deuskane/asylum-soc-picosoc/(list of files, cad)

Other CAD files:
esw/user_identity.psm
