deuskane/asylum-soc-picosoc/esw/user_modbus_rtu.c

//-----------------------------------------------------------------------------
// Title      : Macro to define Address Map for user soc
// Project    : Asylum
//-----------------------------------------------------------------------------
// File       : user_modbus_rtu.c
// Author     : mrosiere
//-----------------------------------------------------------------------------
// Description:
//-----------------------------------------------------------------------------
// Copyright (c) 2025
//-----------------------------------------------------------------------------
// Revisions  :
// Date        Version  Author   Description
// 2025-10-18  1.0      mrosiere Created
//-----------------------------------------------------------------------------

//#include <intr.h>
#include "addrmap_user.h"
#include "modbus_rtu.h"

//--------------------------------------
// Constant
//--------------------------------------
#define UART_RX_LOOPBACK 0
//#define DISABLE_ERROR
//#define DISABLE_WAIT
//#define UART_ECHO
#define CRC_HW

//--------------------------------------
// crc16_next
// Compute one loop of CRC16
//--------------------------------------
uint16_t crc16_next(uint16_t crc,
                    uint8_t  data)
{
#ifndef CRC_HW
  crc = crc ^ data;

  if ((crc & 0x0001) != 0) {crc >>= 1; crc ^= 0xA001;} else { crc >>= 1; }
  if ((crc & 0x0001) != 0) {crc >>= 1; crc ^= 0xA001;} else { crc >>= 1; }
  if ((crc & 0x0001) != 0) {crc >>= 1; crc ^= 0xA001;} else { crc >>= 1; }
  if ((crc & 0x0001) != 0) {crc >>= 1; crc ^= 0xA001;} else { crc >>= 1; }
  if ((crc & 0x0001) != 0) {crc >>= 1; crc ^= 0xA001;} else { crc >>= 1; }
  if ((crc & 0x0001) != 0) {crc >>= 1; crc ^= 0xA001;} else { crc >>= 1; }
  if ((crc & 0x0001) != 0) {crc >>= 1; crc ^= 0xA001;} else { crc >>= 1; }
  if ((crc & 0x0001) != 0) {crc >>= 1; crc ^= 0xA001;} else { crc >>= 1; }
#else
  uint8_t byte0;
  uint8_t byte1;
  
  crc_wr(CRC,DATA0,data);

  byte1 = crc_rd(CRC,CRC1);
  byte0 = crc_rd(CRC,CRC0);
  crc   = ((byte1<<8)|
           (byte0));
#endif
  return crc;
}

//--------------------------------------
// crc16_init
//--------------------------------------
uint16_t crc16_init()
{
  uint16_t crc;

  crc = 0xFFFF;

#ifdef CRC_HW
  crc_wr(CRC,CRC0,0xFF);
  crc_wr(CRC,CRC1,0xFF);
#endif
  
  return crc;
}

//--------------------------------------
// modbus_response
// send byte to uart and accumulate into crc
//--------------------------------------
uint16_t modbus_response (uint16_t crc,
                          uint8_t  byte
                          )
{
  putchar(byte);
  return crc16_next(crc,byte);
}

//--------------------------------------
// modbus_response_crc
// send the crc to uart (LSB first)
//--------------------------------------
void modbus_response_crc (uint16_t crc)
{
  uint8_t byte;

  byte = crc & 0xFF;
  putchar(byte); // CRC : send LSB first

  byte = (crc >> 8)&0xFF;
  putchar(byte);
}

//--------------------------------------
// _getchar
// fonction to wrap macro getchar
//--------------------------------------
uint8_t _getchar()
{
  volatile uint8_t byte = getchar();

#ifdef UART_ECHO
  putchar(byte);
#endif
  
  return byte;
}

//--------------------------------------
// modbus_wait
// Active loop to Wait 3.5T
// If uart have msg : pop and restart compteur
//--------------------------------------

void modbus_wait ()
{
  uint8_t status = 0;

  // Clear IT From UART
  gic_clr(UART,UART_IT_RX_EMPTY_B_MSK);

  // Start Timer
  timer_unclear(TIMER);
  timer_enable (TIMER);

  while (status == 0x00)
    {
      // Get Status from UART
      status  = gic_get(UART);
      status &= UART_IT_RX_EMPTY_B_MSK;

      // Is RX Not Empty ?
      if (status != 0x00)
        {
          // Pop (and ignore)
          _getchar();
          // Clear IT
          gic_clr(UART,UART_IT_RX_EMPTY_B_MSK);
          // Restart the timer
          timer_clear  (TIMER);
          timer_unclear(TIMER);
        }

      // Get Status from UART
      status  = gic_get(TIMER);
      status &= TIMER_IT_DONE_MSK;
    }

  // Disable Timer
  timer_disable(TIMER);
  timer_clear  (TIMER);

  // Clear IT from Timer
  gic_clr(TIMER,TIMER_IT_DONE_MSK);
}

//--------------------------------------
// modbus_id_req
//
// Check if and return 1 if value for request
//--------------------------------------
uint8_t modbus_id_req(uint8_t id)
{
  uint8_t ret = 0;
  
  if (id == MODBUS_ADDRESS)
    ret=1;
  if (id == 0)
    ret=1;
  return ret;
}

//--------------------------------------
// modbus_id_rsp
//
// Check if and return 1 if value for respons
//--------------------------------------
uint8_t modbus_id_rsp(uint8_t id)
{
  uint8_t ret = 0;
  if (id == MODBUS_ADDRESS)
    ret=1;
  return ret;
}

//--------------------------------------
// modbus_slave_read_holding_registers
//--------------------------------------
uint8_t modbus_slave_read_holding_registers(uint8_t id)
{
  uint8_t  slave_id      = id;
  uint8_t  function_code = MODBUS_FC_READ_HOLDING_REGISTERS;
  uint16_t crc           ;
  uint8_t  errcode       = 0;

  // Read Holding Registers
  // Request must be 8 bytes
  // Respons must be 5+2*N bytes
      
  uint8_t  read_addr_msb;
  uint8_t  read_addr_lsb;
  uint8_t  read_addr    ;
  uint8_t  read_len_msb ;
  uint8_t  read_len_lsb ;
  uint8_t  read_len     ;
  uint8_t  crc_rx_lsb   ;
  uint8_t  crc_rx_msb   ;
  uint16_t crc_rx       ;
  uint8_t  i            ;

  do
    {
#ifndef DISABLE_ERROR
      if (modbus_id_rsp(slave_id)==0)
        break;
#endif
        
      read_addr_msb  = _getchar();
      read_addr_lsb  = _getchar();
      read_len_msb   = _getchar();
      read_len_lsb   = _getchar();
      crc_rx_lsb     = _getchar();
      crc_rx_msb     = _getchar();
      crc_rx         = (crc_rx_msb<<8)|crc_rx_lsb;

      // crc after address = 1 and read
      crc = crc16_init();
      crc = crc16_next(crc,slave_id      );
      crc = crc16_next(crc,function_code );
      crc = crc16_next(crc,read_addr_msb);
      crc = crc16_next(crc,read_addr_lsb);
      crc = crc16_next(crc,read_len_msb);
      crc = crc16_next(crc,read_len_lsb);

#ifndef DISABLE_ERROR
      // If CRC is different, just ignore
      if (crc_rx != crc)
        break;

      // Supported Only 8b Address
      if (read_addr_msb != 0x00)
        {
          errcode = MODBUS_ERR_INVALID_ADDR;
          break;
        }

      // Supported Only 8b  
      if (read_len_msb != 0x00)
        {
          errcode = MODBUS_ERR_INVALID_DATA;
          break;
        }
#endif
        
      read_addr      = read_addr_lsb; // ignore MSB
      read_len       = read_len_lsb ; // ignore MSB
        
      // Response :
      // Byte 0 : Slave ID
      // Byte 1 : Function Code
      // Byte 2 : Number of read bytes
      crc = crc16_init();
      crc = modbus_response(crc,slave_id     );
      crc = modbus_response(crc,function_code);
      crc = modbus_response(crc,read_len << 1); // read_len is in read word so 16b

      // Byte 3 : read data MSB
      // Byte 4 : read data LSB
      for (i = 0; i < read_len; i++)
        {
          //uint16_t read_data = holding_registers[read_addr + i];
          //crc = modbus_response(crc,(read_data >> 8  ));
          //crc = modbus_response(crc,(read_data & 0xFF));

          uint8_t read_data = PORT_RD(0,read_addr);
          crc = modbus_response(crc,0x00);
          crc = modbus_response(crc,read_data);
          read_addr ++;
        }

      modbus_response_crc(crc);
    }
  while (0);
  
  return errcode;
}
  
//--------------------------------------
// modbus_slave_write_single_register
//--------------------------------------
uint8_t modbus_slave_write_single_register(uint8_t id)
{
  uint8_t  slave_id      = id;
  uint8_t  function_code = MODBUS_FC_WRITE_SINGLE_REGISTER;
  uint16_t crc           ;
  uint8_t  errcode       = 0;

  // Write Single Register
  uint8_t  write_addr_msb ;
  uint8_t  write_addr_lsb ;
  uint8_t  write_data_msb ;
  uint8_t  write_data_lsb ;
  uint8_t  crc_rx_lsb     ;
  uint8_t  crc_rx_msb     ;
  uint16_t crc_rx         ;

  do
    {
  
#ifndef DISABLE_ERROR
      if (modbus_id_req(slave_id)==0)
        break;
#endif
        
      // Modbus uses 16b address and 16b data
      // here -> ignore MSB
            
      write_addr_msb = _getchar();
      write_addr_lsb = _getchar();
      write_data_msb = _getchar();
      write_data_lsb = _getchar();
      crc_rx_lsb     = _getchar();
      crc_rx_msb     = _getchar();
      crc_rx         = (crc_rx_msb<<8)|crc_rx_lsb;
            
      // crc after address = 1 and write
      crc = crc16_init();
      crc = crc16_next(crc,slave_id      );
      crc = crc16_next(crc,function_code );
      crc = crc16_next(crc,write_addr_msb);
      crc = crc16_next(crc,write_addr_lsb);
      crc = crc16_next(crc,write_data_msb);
      crc = crc16_next(crc,write_data_lsb);

#ifndef DISABLE_ERROR
      // If CRC is different, just ignore
      if (crc_rx != crc)
        break;

      // Supported Only 8b Address
      if (write_addr_msb != 0x00)
        {
          errcode = MODBUS_ERR_INVALID_ADDR;
          break;
        }

      // Supported Only 8b  
      if (write_data_msb != 0x00)
        {
          errcode = MODBUS_ERR_INVALID_DATA;
          break;
        }
#endif
        
      PORT_WR(0,write_addr_lsb,write_data_lsb);

#ifndef DISABLE_ERROR
      if (modbus_id_rsp(slave_id)==0)
        break;
#endif
        
      // Respons is the same like request
      crc = crc16_init();
      crc = modbus_response(crc,slave_id      ); 
      crc = modbus_response(crc,function_code ); 
      crc = modbus_response(crc,0x00          ); 
      crc = modbus_response(crc,write_addr_lsb); 
      crc = modbus_response(crc,0x00          ); 
      crc = modbus_response(crc,write_data_lsb); 
      modbus_response_crc(crc);
    }
  while (0);
  
  return errcode;
}

//--------------------------------------
// modbus_slave
// send byte to uart and accumulate into crc
//--------------------------------------
void modbus_slave ()
{
  uint8_t  slave_id      ;
  uint8_t  function_code ;
  uint16_t crc           ;
  uint8_t  errcode       ;

  // not yet error
  errcode       = 0;

  // Get Slave ID and check
  slave_id      = _getchar();
  
  // Get Function code
  function_code = _getchar();
  
  if      (function_code == MODBUS_FC_READ_HOLDING_REGISTERS)
    {
      errcode = modbus_slave_read_holding_registers(slave_id);
    }
  else if (function_code == MODBUS_FC_WRITE_SINGLE_REGISTER)
    {
      errcode = modbus_slave_write_single_register(slave_id);
    }
  else 
      // Unsupported Function
    {
      errcode = MODBUS_ERR_INVALID_FUNC;
    }
  
  // Have Error ?
  if (errcode != 0)
    {
      crc = crc16_init();
      crc = modbus_response(crc,slave_id      ); 
      crc = modbus_response(crc,(function_code|0x80)); 
      crc = modbus_response(crc,errcode       ); 
      modbus_response_crc(crc);
    }
}

//--------------------------------------
// Interrupt Sub Routine
//--------------------------------------
ISR_FCT
{
}

//--------------------------------------
// Application Setup
//--------------------------------------
void setup()
{
  uint32_t timer_cnt;
  
  // GPIO Setup
  // * SWITCH is Input
  // * LED    are Output and init to 0
  gpio_setup(SWITCH,INPUT);
  gpio_setup(LED0  ,OUTPUT);
  gpio_setup(LED1  ,OUTPUT);
  gpio_wr(LED0,0);
  gpio_wr(LED1,0);

  // UART
  // * Setup the clock frequency and the target Baud Rate
  // * Configurae the Uart RX Loopback
  // * Enable the Interruption UART RX Empty interuption
  uart_setup(UART,CLOCK_FREQ,BAUD_RATE,UART_RX_LOOPBACK);
  gic_it_enable(UART,UART_IT_RX_EMPTY_B_MSK);

  // TIMER
  // * Setup time for 3.5 STOP char
  //   Char = 1 START + 8 DATA + 1 STOP -> 10b
  //   Tchar = 10*CLOCK_FREQ/BAUD_RATE
  timer_cnt = (3.5 * 10 * CLOCK_FREQ)/(BAUD_RATE);
  timer_wr(TIMER,timer_cnt);
  gic_it_enable(TIMER,TIMER_IT_DONE_MSK);
  
  // Setup the interruption handler address in the CPU
  interrupt_setup(isr);

  // Enable Interrtuption in the CPU
  //interrupt_enable();
}


//--------------------------------------
// Main
//--------------------------------------
// Arduino Style, Don't modify
void main()
{

  setup();

  //------------------------------------
  // Application Run Loop
  //------------------------------------

  while (1)
    {
#ifndef DISABLE_WAIT
      modbus_wait   ();
#endif
      modbus_slave  ();
    }
}
