deuskane/asylum-soc-picosoc/hdl/PicoSoC_supervisor.vhd

-------------------------------------------------------------------------------
-- Title      : PicoSoC_supervisor
-- Project    : 
-------------------------------------------------------------------------------
-- File       : PicoSoC_supervisor.vhd
-- Author     : Mathieu Rosiere
-- Company    : 
-- Created    : 2017-03-30
-- Last update: 2026-07-20
-- Platform   : 
-- Standard   : VHDL'93/02
-------------------------------------------------------------------------------
-- Description: 
-------------------------------------------------------------------------------
-- Copyright (c) 2017 
-------------------------------------------------------------------------------
-- Revisions  :
-- Date        Version  Author   Description
-- 2025-01-01  1.0      mrosiere Created
-- 2025-04-02  1.1      mrosiere Add ICN
-- 2025-07-05  1.2      mrosiere Use GIC instead GPIO
-- 2026-05-17  1.3      mrosiere Add RAM
-- 2026-08-01  1.4      mrosiere Use GPIO_irq instead of GPIO
-------------------------------------------------------------------------------

library ieee;
use     ieee.std_logic_1164.all;
use     ieee.numeric_std.all;
library asylum;

-- Type Package
use     asylum.sbi_pkg.all;
use     asylum.math_pkg.all;
-- CSR Package
use     asylum.GPIO_irq_csr_pkg.all;
use     asylum.GIC_csr_pkg.all;
-- Modules Packages
use     asylum.PicoSoC_pkg.all;
use     asylum.gpio_pkg.all;
use     asylum.gic_pkg.all;
use     asylum.icn_pkg.all;
use     asylum.ram_pkg.all;
use     asylum.ROM_supervisor_pkg.all;

entity PicoSoC_supervisor is
  generic
    (NB_LED0               : positive := 8
    ;NB_LED1               : positive := 8

    ;ICN_TARGET_SEL        : string   := "or"
    ;ICN_MASTER_SEL        : string   := "fix"

    ;NB_CPU                : natural  := 1
    ;CPU_MODEL             : string   := "OpenBlaze8" 
    ;RAM_DEPTH             : natural  := 128
    );
  port
    (clk_i                 : in  std_logic
    ;arst_b_i              : in  std_logic
                          
    ;led0_o                : out std_logic_vector(NB_LED0  -1 downto 0)
    ;led1_o                : out std_logic_vector(NB_LED1  -1 downto 0)
                          
    ;diff_i                : in  std_logic_vector(        3-1 downto 0)
                          
    ;debug_o               : out PicoSoC_supervisor_debug_t
     );
end PicoSoC_supervisor;

architecture rtl of PicoSoC_supervisor is
  -- Constant declaration
  constant CST0                       : std_logic_vector (8-1 downto 0) := (others => '0');
  constant CST1                       : std_logic_vector (8-1 downto 0) := (others => '1');

  -- CPU parameters
  constant CPU_IMEM_ADDR_WIDTH        : positive := ROM_supervisor_ADDR_WIDTH;
  constant CPU_IMEM_DATA_WIDTH        : positive := ROM_supervisor_DATA_WIDTH;
  constant CPU_DMEM_ADDR_WIDTH        : positive := SBI_ADDR_WIDTH;
  constant CPU_DMEM_DATA_WIDTH        : positive := SBI_DATA_WIDTH;

  -- ICN Configuration
  constant ICN_NB_MASTER              : positive := NB_CPU;

  constant ICN_TARGET_ADDR_ENCODING   : string   := PICOSOC_SUPERVISOR_ADDR_ENCODING;

  constant ICN_TARGET_LED0            : integer  := 0;
  constant ICN_TARGET_LED1            : integer  := 1;
  constant ICN_TARGET_GIC             : integer  := 2;
  constant ICN_TARGET_RAM             : integer  := 3;

  constant ICN_NB_TARGET              : positive := 4;

  constant ICN_TARGET_ID              : sbi_addrs_t   (ICN_NB_TARGET-1 downto 0) :=
    ( ICN_TARGET_LED0                 => PICOSOC_SUPERVISOR_LED0_BA
     ,ICN_TARGET_LED1                 => PICOSOC_SUPERVISOR_LED1_BA
     ,ICN_TARGET_GIC                  => PICOSOC_SUPERVISOR_GIC_BA 
     ,ICN_TARGET_RAM                  => PICOSOC_SUPERVISOR_RAM_BA
      );
  constant ICN_TARGET_ADDR_WIDTH      : naturals_t    (ICN_NB_TARGET-1 downto 0) :=
    ( ICN_TARGET_LED0                 => GPIO_IRQ_ADDR_WIDTH
     ,ICN_TARGET_LED1                 => GPIO_IRQ_ADDR_WIDTH
     ,ICN_TARGET_GIC                  => GIC_ADDR_WIDTH
     ,ICN_TARGET_RAM                  => log2(RAM_DEPTH)
      );
      
  -- Signals Clock/Reset
  signal clk                          : std_logic;
  signal arst_b                       : std_logic;
  
  -- Signals CPUs
  signal cpu_ics                      : std_logic;
  signal cpu_iaddr                    : std_logic_vector(CPU_IMEM_ADDR_WIDTH-1 downto 0);
  signal cpu_idata                    : std_logic_vector(CPU_IMEM_DATA_WIDTH-1 downto 0);
  
  signal cpu_sbi_ini                  : sbi_ini_t(addr (CPU_DMEM_ADDR_WIDTH-1 downto 0),
                                                  wdata(CPU_DMEM_DATA_WIDTH-1 downto 0));
  signal cpu_sbi_tgt                  : sbi_tgt_t(rdata(CPU_DMEM_DATA_WIDTH-1 downto 0));

  signal cpu_it_val                   : std_logic;
--signal cpu_it_ack                   : std_logic;

  -- Signals ICN
  signal icn_sbi_inim                 : sbi_inis_t(ICN_NB_MASTER-1 downto 0)(addr (CPU_DMEM_ADDR_WIDTH-1 downto 0),
                                                                             wdata(CPU_DMEM_DATA_WIDTH-1 downto 0));
  signal icn_sbi_tgtm                 : sbi_tgts_t(ICN_NB_MASTER-1 downto 0)(rdata(CPU_DMEM_DATA_WIDTH-1 downto 0));

  signal icn_sbi_inis                 : sbi_inis_t(ICN_NB_TARGET-1 downto 0)(addr (CPU_DMEM_ADDR_WIDTH-1 downto 0),
                                                                             wdata(CPU_DMEM_DATA_WIDTH-1 downto 0));
  signal icn_sbi_tgts                 : sbi_tgts_t(ICN_NB_TARGET-1 downto 0)(rdata(CPU_DMEM_DATA_WIDTH-1 downto 0));
  
  signal led0                         : std_logic_vector(NB_LED0-1 downto 0);
  signal led1                         : std_logic_vector(NB_LED1-1 downto 0);
  
  -- Interruption Vector
  constant GIC_ITS_SYNC_ENABLE        : std_logic_vector(diff_i'range) := (others      => '0');
  
begin  -- architecture rtl

  -----------------------------------------------------------------------------
  -- Clock & Reset
  -----------------------------------------------------------------------------
  clk    <= clk_i;
  arst_b <= arst_b_i;
  
  -----------------------------------------------------------------------------
  -- CPU 0
  -----------------------------------------------------------------------------
  ins_cpu : entity asylum.cpu_wrapper
    generic map
    (CPU_MODEL            => CPU_MODEL
    )
    port map
    (clk_i                => clk      
    ,cke_i                => '1'      
    ,arst_b_i             => arst_b   
    ,ics_o                => cpu_ics  
    ,iaddr_o              => cpu_iaddr
    ,idata_i              => cpu_idata
    ,sbi_ini_o            => cpu_sbi_ini  
    ,sbi_tgt_i            => cpu_sbi_tgt  
    ,interrupt_i          => cpu_it_val   
    ,interrupt_ack_o      => open
    );

  icn_sbi_inim(0) <= cpu_sbi_ini;
  cpu_sbi_tgt     <= icn_sbi_tgtm(0);

  -----------------------------------------------------------------------------
  -- CPU ROM
  -----------------------------------------------------------------------------
  ins_ROM_supervisor : entity asylum.ROM_supervisor(rom)
    port map
    (clk_i                => clk      
    ,cke_i                => cpu_ics
    ,address_i            => cpu_iaddr
    ,instruction_o        => cpu_idata  
    );

  -----------------------------------------------------------------------------
  -- Interconnect
  -- From 1 Initiator to N Target
  -----------------------------------------------------------------------------
  ins_sbi_icn : sbi_icn
    generic map
    (NAME                 => "icn_supervisor"
    ,NB_MASTER            => ICN_NB_MASTER
    ,MASTER_SEL           => ICN_MASTER_SEL
    ,NB_TARGET            => ICN_NB_TARGET
    ,TARGET_SEL           => ICN_TARGET_SEL
    ,TARGET_ID            => ICN_TARGET_ID
    ,TARGET_ADDR_WIDTH    => ICN_TARGET_ADDR_WIDTH
    ,TARGET_ADDR_ENCODING => ICN_TARGET_ADDR_ENCODING
     )
    port map
    (clk_i                => clk        
    ,cke_i                => '1'        
    ,arst_b_i             => arst_b     
    ,sbi_inis_i           => icn_sbi_inim
    ,sbi_tgts_o           => icn_sbi_tgtm  
    ,sbi_inis_o           => icn_sbi_inis   
    ,sbi_tgts_i           => icn_sbi_tgts
     );

  -----------------------------------------------------------------------------
  -- GPIO 0 - LED
  -- Used as resetb for soc user
  -----------------------------------------------------------------------------
  ins_sbi_led0 : sbi_GPIO_irq
    generic map
    (NAME                 => "USER_ARST"
    ,NB_IO                => NB_LED0
    ,DATA_OE_INIT         => CST1(8-1 downto 0)
    ,IRQ_POSEDGE          => X"00"
    ,IRQ_NEGEDGE          => X"00"
   )
    port map
    (clk_i                => clk         
    ,cke_i                => '1'         
    ,arstn_i              => arst_b      
    ,sbi_ini_i            => icn_sbi_inis(ICN_TARGET_LED0)
    ,sbi_tgt_o            => icn_sbi_tgts(ICN_TARGET_LED0)
    ,data_i               => CST0(NB_LED0-1 downto 0)
    ,data_o               => led0        
    ,data_oe_o            => open   
    ,it_o                 => open       
    );

  -----------------------------------------------------------------------------
  -- GPIO 1 - LED
  -----------------------------------------------------------------------------
  ins_sbi_led1 : sbi_GPIO_irq
    generic map
    (NAME                 => "LED_DIFF"
    ,NB_IO                => NB_LED1
    ,DATA_OE_INIT         => CST1(8-1 downto 0)
    ,IRQ_POSEDGE          => X"00"
    ,IRQ_NEGEDGE          => X"00"
    )
    port map
    (clk_i                => clk         
    ,cke_i                => '1'         
    ,arstn_i              => arst_b      
    ,sbi_ini_i            => icn_sbi_inis(ICN_TARGET_LED1)
    ,sbi_tgt_o            => icn_sbi_tgts(ICN_TARGET_LED1)
    ,data_i               => CST0(NB_LED1-1 downto 0)
    ,data_o               => led1        
    ,data_oe_o            => open        
    ,it_o                 => open       
    );

  -----------------------------------------------------------------------------
  -- GIC - Interruption Vector
  -----------------------------------------------------------------------------
  ins_sbi_gic : sbi_GIC
    generic map
    (ITS_SYNC_ENABLE      => GIC_ITS_SYNC_ENABLE
     )
    port map
    (clk_i                => clk         
    ,arst_b_i             => arst_b      
    ,sbi_ini_i            => icn_sbi_inis(ICN_TARGET_GIC)
    ,sbi_tgt_o            => icn_sbi_tgts(ICN_TARGET_GIC)
    ,its_i                => diff_i      
    ,itm_o                => cpu_it_val
    );
  
  -----------------------------------------------------------------------------
  -- RAM
  -----------------------------------------------------------------------------
  ins_sbi_ram : sbi_ram
    generic map
    (DEPTH                => RAM_DEPTH
    ,SYNC_READ            => true   
   )
    port map
    (clk_i                => clk         
    ,arst_b_i             => arst_b      
    ,sbi_ini_i            => icn_sbi_inis(ICN_TARGET_RAM)
    ,sbi_tgt_o            => icn_sbi_tgts(ICN_TARGET_RAM)
    );
 
  -----------------------------------------------------------------------------
  -- Output
  -----------------------------------------------------------------------------
  led0_o <= led0;
  led1_o <= led1;

  -----------------------------------------------------------------------------
  -- Debug
  -----------------------------------------------------------------------------
  debug_o.arst_b <= arst_b;
  
end architecture rtl;
    
  
