deuskane/asylum-soc-picosoc/esw/include/cpu.h

//-----------------------------------------------------------------------------
// Title      : Macro for cpu
// Project    : Asylum
//-----------------------------------------------------------------------------
// File       : cpu.h
// Author     : mrosiere
//-----------------------------------------------------------------------------
// Description:
//-----------------------------------------------------------------------------
// Copyright (c) 2025
//-----------------------------------------------------------------------------
// Revisions  :
// Date        Version  Author   Description
// 2026-05-17  1.0      mrosiere Created
//-----------------------------------------------------------------------------

#ifndef _cpu_h_
#define _cpu_h_

#ifdef picoblaze

#include "cpu/picoblaze.h"

#else

#include "cpu/riscv.h"

#endif
#endif
