deuskane/asylum-soc-picosoc/esw/include/addrmap_supervisor.h

//-----------------------------------------------------------------------------
// Title      : Macro to define Address Map for supervisor soc
// Project    : Asylum
//-----------------------------------------------------------------------------
// File       : addrmap_supervisor.h
// Author     : mrosiere
//-----------------------------------------------------------------------------
// Description:
//-----------------------------------------------------------------------------
// Copyright (c) 2025
//-----------------------------------------------------------------------------
// Revisions  :
// Date        Version  Author   Description
// 2025-07-31  1.0      mrosiere Created
//-----------------------------------------------------------------------------

#ifndef _addrmap_supervisor_h_
#define _addrmap_supervisor_h_

//--------------------------------------
// IP
//--------------------------------------

#include "picoblaze.h"
#include "gpio.h"
#include "gic.h"

//--------------------------------------
// Address Map
//--------------------------------------
#define RST                 0x10
#define LED                 0x20
#define GIC                 0x40

#endif
