deuskane/asylum-soc-picosoc/sim/tb_PicoSoC.vhd

-------------------------------------------------------------------------------
-- Title      : tb_PicoSoC
-- Project    : 
-------------------------------------------------------------------------------
-- File       : tb_PicoSoC.vhd
-- Author     : Mathieu Rosiere
-- Company    : 
-- Created    : 2017-03-30
-- Last update: 2026-01-10
-- Platform   : 
-- Standard   : VHDL'93/02
-------------------------------------------------------------------------------
-- Description: 
-------------------------------------------------------------------------------
-- Copyright (c) 2017 
-------------------------------------------------------------------------------
-- Revisions  :
-- Date        Version  Author  Description
-- 2017-03-30  1.0      mrosiere Created
-- 2025-01-11  1.1      mrosiere Add fault test
-------------------------------------------------------------------------------

library ieee;
use     ieee.std_logic_1164.all;
use     ieee.numeric_std.all;
use     std.textio.all;
library asylum;
use     asylum.PicoSoC_pkg.all;
use     asylum.spi_pkg.all;
library work;
  
entity tb_PicoSoC is
  generic
    (FSYS                  : positive := 50_000_000
    ;FSYS_INT              : positive := 50_000_000
    ;USER_NB_CPU           : positive := 1
    ;USER_BAUD_RATE        : integer  := 115200
  --;USER_UART_DEPTH_TX    : natural  := 0
  --;USER_UART_DEPTH_RX    : natural  := 0
  --;USER_SPI_DEPTH_CMD    : natural  := 0
  --;USER_SPI_DEPTH_TX     : natural  := 0
  --;USER_SPI_DEPTH_RX     : natural  := 0
  --;USER_NB_SWITCH        : positive := 8
  --;USER_NB_LED0          : positive := 8
  --;USER_NB_LED1          : positive := 8
  --;RESET_POLARITY        : string   := "low"       -- "high" / "low"
    ;SUPERVISOR            : boolean  := True 
    ;USER_SAFETY           : string   := "lock-step" -- "none" / "lock-step" / "tmr"
    ;USER_FAULT_INJECTION  : boolean  := True  
  --;USER_IT_POLARITY      : string   := "low"       -- "high" / "low"
  --;USER_FAULT_POLARITY   : string   := "low"       -- "high" / "low"
    ;DEBUG_ENABLE          : boolean  := True 
    ;CPU_MODEL             : string   := ""          -- "OpenBlaze8" / "WardRV_fsm"

    -- TB Parameters
    ;TEST_SUITE            : string   := "default"   -- "default"/"none" 
    ;TB_WATCHDOG           : natural  := 10_000
    ;SPI_MODEL             : string   := "none"      -- "none" / "m25p40" / "s25fl512s"

     );
  
end entity tb_PicoSoC;

architecture tb of tb_PicoSoC is
  -- =====[ Parameters ]==========================
  constant TB_PERIOD               : time    := (1e9 / FSYS) * 1 ns;
  constant TB_WATCHDOG_TIME        : time    := TB_WATCHDOG * TB_PERIOD;

  constant USER_NB_SWITCH          : positive :=  8;
  constant USER_NB_LED0            : positive :=  8;
  constant USER_NB_LED1            : positive :=  8;
  constant USER_SPI_NB_IO          : positive :=  8;

  constant RESET_POLARITY          : string   := "low";  -- "high" / "low"
  constant USER_IT_POLARITY        : string   := "high"; -- "high" / "low"
  constant USER_FAULT_POLARITY     : string   := "high"; -- "high" / "low"
  
  -- =====[ Dut Signals ]=========================
  signal  clk_i                    : std_logic := '0';
  signal  arst_b_i                 : std_logic;
  signal  switch_i                 : std_logic_vector(USER_NB_SWITCH-1 downto 0);
  signal  led0_o                   : std_logic_vector(USER_NB_LED0  -1 downto 0);
  signal  led1_o                   : std_logic_vector(USER_NB_LED1  -1 downto 0);
  signal  led_diff_o               : std_logic_vector(             3-1 downto 0);
  signal  it_user_i                : std_logic;
  signal  inject_error_i           : std_logic_vector(             3-1 downto 0);

  signal  spi_sclk_io              : std_logic;
  signal  spi_cs_b_io              : std_logic;
  signal  spi_io_io                : std_logic_vector(USER_SPI_NB_IO-1 downto 0);

  signal  RSTNeg                   : std_logic;
  
  alias   led_switch               : std_logic_vector(USER_NB_SWITCH-1 downto 0) is led0_o(USER_NB_SWITCH-1 downto  0);
  alias   led_it                   : std_logic_vector(USER_NB_LED1  -1 downto 0) is led1_o;
  alias   led_diff                 : std_logic_vector(             3-1 downto 0) is led_diff_o;

  -- =====[ Test Signals ]========================
  signal  test_begin               : std_logic := '0';
  signal  test_done                : std_logic := '0';
  
  -- =====[ Functions ]===========================
  
  -----------------------------------------------------------------------------
  -- xrun
  -----------------------------------------------------------------------------
  procedure xrun
    (constant n     : in positive;           -- nb cycle
     constant pol   : in string;
     signal   clk   : in std_logic
     ) is
    
  begin
    for i in 0 to n-1
    loop
      if (pol="pos")
      then
        wait until rising_edge(clk);
      else
        wait until falling_edge(clk);
      end if;
      
    end loop;  -- i
  end xrun;

  -----------------------------------------------------------------------------
  -- run
  -----------------------------------------------------------------------------
  procedure run
    (constant n     : in positive;          -- nb cycle
     constant pol   : in string := "pos"
     ) is
    
  begin
    xrun(n,"pos",clk_i);
  end run;

begin  -- architecture tb

  -----------------------------------------------------------------------------
  -- Design Under Test
  -----------------------------------------------------------------------------
  dut : PicoSoC_top
    generic map
    (FSYS                  => FSYS            
    ,FSYS_INT              => FSYS_INT        
    ,USER_NB_CPU           => USER_NB_CPU
    ,USER_BAUD_RATE        => USER_BAUD_RATE
    ,USER_NB_SWITCH        => USER_NB_SWITCH       
    ,USER_NB_LED0          => USER_NB_LED0        
    ,USER_NB_LED1          => USER_NB_LED1   
    ,USER_SPI_NB_IO        => USER_SPI_NB_IO     
    ,RESET_POLARITY        => RESET_POLARITY  
    ,SUPERVISOR            => SUPERVISOR      
    ,USER_SAFETY           => USER_SAFETY          
    ,USER_FAULT_INJECTION  => USER_FAULT_INJECTION 
    ,USER_IT_POLARITY      => USER_IT_POLARITY
    ,USER_FAULT_POLARITY   => USER_FAULT_POLARITY  
    ,CPU_MODEL             => CPU_MODEL
     )  
    port map
    (clk_i            => clk_i           
    ,arst_i           => arst_b_i        
    ,switch_i         => switch_i        
    ,led0_o           => led0_o
    ,led1_o           => led1_o
    ,led_diff_o       => led_diff_o
    ,it_user_i        => it_user_i     
    ,inject_error_i   => inject_error_i
    ,uart_tx_o        => open
    ,uart_rx_i        => '1'
    ,uart_cts_b_i     => '0'
    ,uart_rts_b_o     => open
    ,spi_sclk_io      => spi_sclk_io
    ,spi_cs_b_io      => spi_cs_b_io
    ,spi_io_io        => spi_io_io
    ,debug_mux_i      => "000"
    ,debug_o          => open 
    ,debug_uart_tx_o  => open
    );

  -----------------------------------------------------------------------------
  -- Clock Tree
  -----------------------------------------------------------------------------
  clk_i <= not test_done and not clk_i after TB_PERIOD/2;

  -----------------------------------------------------------------------------
  -- Memory Model
  -----------------------------------------------------------------------------
  RSTNeg  <= '1';

  gen_m25p40:
  if SPI_MODEL = "m25p40" 
  generate
    mem : entity work.m25p40(vhdl_behavioral)
      generic map 
      (mem_file_name  => "memory.mem"
      ,UserPreload    => true
      ,DebugInfo      => true
      ,TimingChecksOn => true
      ,MsgOn          => true
      ,XOn            => true
      ,LongTimming    => False
      )
      port map
      (D             => spi_io_io(SPI_IO_MOSI)
      ,Q             => spi_io_io(SPI_IO_MISO)
      ,C             => spi_sclk_io
      ,SNeg          => spi_cs_b_io
      ,WNeg          => spi_io_io(SPI_IO_WP_B)
      ,HOLDNeg       => spi_io_io(SPI_IO_HOLD_B)
      );
  end generate;

  gen_s25fl512s:
  if SPI_MODEL = "s25fl512s" 
  generate
    mem : entity work.s25fl512s(vhdl_behavioral_static_memory_allocation)
      generic map
      (mem_file_name  => "memory.mem"
      ,otp_file_name  => "none"
      ,UserPreload    => true
      ,TimingChecksOn => true
      ,MsgOn          => true
      ,XOn            => true
      ,TimingModel    => "S25FL512SAGMFI010_F_30pF"
      ,LongTimming    => false
      )
      PORT MAP
      (SI            => spi_io_io(SPI_IO_MOSI)
      ,SO            => spi_io_io(SPI_IO_MISO)
      ,SCK           => spi_sclk_io
      ,CSNeg         => spi_cs_b_io
      ,WPNeg         => spi_io_io(SPI_IO_WP_B)
      ,HOLDNeg       => spi_io_io(SPI_IO_HOLD_B)
      ,RSTNeg        => RSTNeg
      );
  end generate;
  
  -----------------------------------------------------------------------------
  -- Watchdog
  -----------------------------------------------------------------------------
  p_watchdog: process is
  begin
    while (test_begin = '0')
    loop
      run(1);
    end loop;

    wait for TB_WATCHDOG_TIME;

    run(1);
    
    assert (test_done = '1') report "[TESTBENCH] Test KO : Maximum cycle is reached" severity failure;

    -- end of process
    wait;
  end process;
  
  -----------------------------------------------------------------------------
  -- Test suite
  -----------------------------------------------------------------------------
  process is
  begin  -- process

      run(10);

      report "[TESTBENCH] Init signals";
      it_user_i      <= '0';             -- active low
      inject_error_i <= (others => '0'); -- active low

      report "[TESTBENCH] Reset Sequence"; 
      arst_b_i       <= '0';

      if SPI_MODEL /= "none"
      then
        wait for 10 ms;
      end if;
      
      run(1);

      test_begin     <= '1';
      arst_b_i       <= '1';

      -------------------------------------------------------------------------
      if TEST_SUITE = "default"
      -------------------------------------------------------------------------
      then
      
        report "[TESTBENCH] Change Switch" ;
        switch_i       <= (others => '0');
        for i in USER_NB_SWITCH-1 downto 0 loop
          report "[TESTBENCH]   Switch " & integer'image(i);
          switch_i(i)    <= '1';
          wait until (led_switch = switch_i) ;
          
        end loop;  -- i
  
        report "[TESTBENCH] User Interruption" ;
        run(1,"neg");
        it_user_i        <= '1';
        run(1,"neg");
        it_user_i        <= '0';
        run(1000);
  
        run(1,"neg");
        it_user_i        <= '1';
        run(100);
        run(1,"neg");
        it_user_i        <= '0';
        run(1000);
        
        if (USER_FAULT_INJECTION and SUPERVISOR and USER_SAFETY="lock-step")
        then
          report "[TESTBENCH] Inject error (lock-step)" ;
          assert led_diff = "000" report "Bad value of led_diff" severity failure;
          
          report "[TESTBENCH] Inject error in CPU0" ;
          inject_error_i(0) <= '1';
          run(100);
          inject_error_i(0) <= '0';
  
          while (not (led_switch /= switch_i))
          loop
            run(1);
          end loop;
          while (not (led_switch  = switch_i))
          loop
            run(1);
          end loop;
  
          report "[TESTBENCH] Inject error in CPU1" ;
          inject_error_i(1) <= '1';
          run(100);
          inject_error_i(1) <= '0';
  
          while (not (led_switch /= switch_i))
          loop
            run(1);
          end loop;
          while (not (led_switch  = switch_i))
          loop
            run(1);
          end loop;
  
          report "[TESTBENCH] Inject error in CPU0 in continue" ;
          inject_error_i(1) <= '1';
          run(100);
          inject_error_i(1) <= '0';
  
        end if;
  
        if (USER_FAULT_INJECTION and SUPERVISOR and USER_SAFETY="tmr")
        then
          report "[TESTBENCH] Inject error (TMR)" ;
          assert led_diff = "000" report "Bad value of led_diff" severity failure;
          
          report "[TESTBENCH] Inject error in CPU0" ;
          inject_error_i(0) <= '1';
          run(100);
          inject_error_i(0) <= '0';
  
          run(100);
          assert led_switch  = switch_i report "Bad value of led_switch" severity failure;
          assert led_diff    = "000"    report "Bad value of led_diff"   severity failure;
  
          report "[TESTBENCH] Inject error in CPU1" ;
          inject_error_i(1) <= '1';
          run(100);
          inject_error_i(1) <= '0';
  
          while (not (led_switch /= switch_i))
          loop
            run(1);
          end loop;
          while (not (led_switch  = switch_i))
          loop
            run(1);
          end loop;
  
          assert led_switch  = switch_i report "Bad value of led_switch" severity failure;
          assert led_diff    = "001"    report "Bad value of led_diff"   severity failure;
  
          report "[TESTBENCH] Inject error in CPU2" ;
          inject_error_i(2) <= '1';
          run(100);
          inject_error_i(2) <= '0';
  
          run(100);
          assert led_switch  = switch_i report "Bad value of led_switch" severity failure;
          assert led_diff    = "001"    report "Bad value of led_diff"   severity failure;
  
          report "[TESTBENCH] Inject error in CPU2" ;
          inject_error_i(2) <= '1';
          run(100);
          inject_error_i(2) <= '0';
  
          run(100);
          assert led_switch  = switch_i report "Bad value of led_switch" severity failure;
          assert led_diff    = "001"    report "Bad value of led_diff"   severity failure;
          
          report "[TESTBENCH] Inject error in CPU1" ;
          inject_error_i(1) <= '1';
          run(100);
          inject_error_i(1) <= '0';
  
          while (not (led_switch /= switch_i))
          loop
            run(1);
          end loop;
          while (not (led_switch  = switch_i))
          loop
            run(1);
          end loop;
  
          assert led_diff    = "010"    report "Bad value of led_diff"   severity failure;
          
          report "[TESTBENCH] Inject error in CPU0 in continue" ;
          inject_error_i(1) <= '1';
          run(100);
          inject_error_i(1) <= '0';
  
          assert led_switch  = switch_i report "Bad value of led_switch" severity failure;
          assert led_diff    = "010"    report "Bad value of led_diff"   severity failure;
  
        end if;
      end if;
        
      -------------------------------------------------------------------------
      if TEST_SUITE = "none"
      -------------------------------------------------------------------------
      then
        -- just run
        wait for TB_WATCHDOG_TIME;

      end if;

      report "[TESTBENCH] Test OK";
      test_done <= '1';
      wait;
  end process;


end architecture tb;
