deuskane/asylum-soc-picosoc/sim/tb_PicoSoC_modbus_rtu.vhd

-------------------------------------------------------------------------------
-- Title      : tb_PicoSoC_modbus_rtu
-- Project    : 
-------------------------------------------------------------------------------
-- File       : tb_PicoSoC_modbus_rtu.vhd
-- Author     : Mathieu Rosiere
-- Company    : 
-- Created    : 2025-10-23
-- Last update: 2026-05-24
-- Platform   : 
-- Standard   : VHDL'93/02
-------------------------------------------------------------------------------
-- Description: 
-------------------------------------------------------------------------------
-- Copyright (c) 2025
-------------------------------------------------------------------------------
-- Revisions  :
-- Date        Version  Author  Description
-- 2025-10-23  1.0      mrosiere Created
-------------------------------------------------------------------------------

library ieee;
use     ieee.std_logic_1164.all;
use     ieee.numeric_std.all;
use     std.textio.all;
library asylum;
use     asylum.PicoSoC_pkg.all;
use     asylum.gpio_irq_csr_pkg.all;
library work;

library uvvm_util;
use     uvvm_util.methods_pkg.all;
context uvvm_util.uvvm_util_context;
library bitvis_vip_uart;
use     bitvis_vip_uart.uart_bfm_pkg.all;

entity tb_PicoSoC_modbus_rtu is
  generic
    (FSYS                  : positive := 50_000_000
    ;FSYS_INT              : positive := 50_000_000
    ;USER_BAUD_RATE        : integer  := 115200
    ;USER_UART_DEPTH_TX    : natural  := 8
    ;USER_UART_DEPTH_RX    : natural  := 8
  --;USER_SPI_DEPTH_CMD    : natural  := 0
  --;USER_SPI_DEPTH_TX     : natural  := 0
  --;USER_SPI_DEPTH_RX     : natural  := 0
  --;USER_NB_SWITCH        : positive := 8
  --;USER_NB_LED0          : positive := 8
  --;USER_NB_LED1          : positive := 8
  --;RESET_POLARITY        : string   := "low"       -- "high" / "low"
    ;SUPERVISOR            : boolean  := True 
    ;USER_SAFETY           : string   := "lock-step" -- "none" / "lock-step" / "tmr"
    ;USER_FAULT_INJECTION  : boolean  := True  
  --;USER_IT_POLARITY      : string   := "low"       -- "high" / "low"
  --;USER_FAULT_POLARITY   : string   := "low"       -- "high" / "low"
    ;DEBUG_ENABLE          : boolean  := True
    ;CPU_MODEL             : string   := ""          -- "OpenBlaze8" / "WardRV_fsm"

    -- TB Parameters
    ;TB_WATCHDOG           : natural  := 10_000
    ;HAVE_SPI_MEMORY       : boolean  := False
     );

end entity tb_PicoSoC_modbus_rtu;

architecture tb of tb_PicoSoC_modbus_rtu is

  -- =====[ Test Case ]===========================
  constant TEST_CASE_BASIC         : boolean   := true;
  constant TEST_CASE_FAULT         : boolean   := USER_FAULT_INJECTION;
  constant TEST_CASE_SEQUENCE      : boolean   := true;

  -- =====[ Parameters ]==========================
  constant TB_PERIOD               : time    := (1e9 / FSYS) * 1 ns;
  constant TB_WATCHDOG_TIME        : time    := TB_WATCHDOG * TB_PERIOD;

  constant C_ERROR_DURATION        : time    :=   2 us;
  constant C_ERROR_LATENCY         : time    :=  20 us; -- Time between error injection and error detection (difference led on)
  constant C_RESET_LATENCY         : time    := 200 us;

  constant USER_NB_SWITCH          : positive :=  8;
  constant USER_NB_LED0            : positive :=  8;
  constant USER_NB_LED1            : positive :=  8;

  constant RESET_POLARITY          : string   := "low";  -- "high" / "low"
  constant USER_IT_POLARITY        : string   := "high"; -- "high" / "low"
  constant USER_FAULT_POLARITY     : string   := "high"; -- "high" / "low"

  -- =====[ Dut Signals ]=========================
  signal   clk_i                   : std_logic := '0';
  signal   arst_b_i                : std_logic := '1';
  signal   switch_i                : std_logic_vector(USER_NB_SWITCH-1 downto 0);
  signal   led0_o                  : std_logic_vector(USER_NB_LED0  -1 downto 0);
  signal   led1_o                  : std_logic_vector(USER_NB_LED1  -1 downto 0);
  signal   led_diff_o              : std_logic_vector(             3-1 downto 0);
  signal   it_user_i               : std_logic;
  signal   inject_error_i          : std_logic_vector(             3-1 downto 0);
  signal   uart_tx_o               : std_logic;
  signal   uart_rx_i               : std_logic := '1';

  alias    led_switch              : std_logic_vector(USER_NB_SWITCH-1 downto 0) is led0_o(USER_NB_SWITCH-1 downto  0);
  alias    led_it                  : std_logic_vector(USER_NB_LED1  -1 downto 0) is led1_o;
  alias    led_diff                : std_logic_vector(             3-1 downto 0) is led_diff_o;
           
  -- =====[ TB Signals ]==========================
  signal   cke                     : boolean   := false;

  signal   uart_terminate_loop     : std_logic := '0';
  signal   debug_crc               : std_logic_vector(16-1 downto 0);
  
  -- =====[ TB Constants ]========================
  constant C_CLK_PERIOD            : time      := 1 sec / FSYS;
  constant C_UART_BIT_TIME         : time      := 1 sec / USER_BAUD_RATE;
  
  constant C_UART_BFM_CONFIG       : t_uart_bfm_config := (
    bit_time                              => C_UART_BIT_TIME,
    num_data_bits                         => 8,
    idle_state                            => '1',
    num_stop_bits                         => STOP_BITS_ONE,
    parity                                => PARITY_NONE,
    timeout                               => 0 ns, -- will default never time out
    timeout_severity                      => error,
    num_bytes_to_log_before_expected_data => 10,
    match_strictness                      => MATCH_EXACT,
    id_for_bfm                            => ID_BFM,
    id_for_bfm_wait                       => ID_BFM_WAIT,
    id_for_bfm_poll                       => ID_BFM_POLL,
    id_for_bfm_poll_summary               => ID_BFM_POLL_SUMMARY,
    error_injection                       => C_BFM_ERROR_INJECTION_INACTIVE
    );

  -- =====[ MODBUS ]==============================
  constant C_MODBUS_SLAVE_ID       : std_logic_vector(8-1 downto 0) := x"5A";
  constant C_MODBUS_READ           : std_logic_vector(8-1 downto 0) := x"03";
  constant C_MODBUS_WRITE          : std_logic_vector(8-1 downto 0) := x"06";

  -- =====[ SOC ADDRMAP ]=========================
  constant C_SWITCH_BA             : std_logic_vector(8-1 downto 0) := PICOSOC_USER_SWITCH_BA;
  constant C_SWITCH_DATA           : std_logic_vector(8-1 downto 0) := std_logic_vector(unsigned(PICOSOC_USER_SWITCH_BA) + resize(GPIO_IRQ_DATA, 8));
  constant C_LED0_BA               : std_logic_vector(8-1 downto 0) := PICOSOC_USER_LED0_BA  ;
  constant C_LED0_DATA             : std_logic_vector(8-1 downto 0) := std_logic_vector(unsigned(PICOSOC_USER_LED0_BA  ) + resize(GPIO_IRQ_DATA, 8));
  constant C_LED1_BA               : std_logic_vector(8-1 downto 0) := PICOSOC_USER_LED1_BA  ;
  constant C_UART_BA               : std_logic_vector(8-1 downto 0) := PICOSOC_USER_UART_BA  ;
  constant C_SPI_BA                : std_logic_vector(8-1 downto 0) := PICOSOC_USER_SPI_BA   ;
  constant C_GIC_BA                : std_logic_vector(8-1 downto 0) := PICOSOC_USER_GIC_BA   ;
  constant C_TIMER_BA              : std_logic_vector(8-1 downto 0) := PICOSOC_USER_TIMER_BA ;
  constant C_CRC_BA                : std_logic_vector(8-1 downto 0) := PICOSOC_USER_CRC_BA   ;

  -- =====[ Function ]============================
  -- Fonction CRC16 (Modbus, polynôme 0xA001)
  function crc16_next(
    crc  : std_logic_vector(16-1 downto 0);
    data : std_logic_vector(8-1 downto 0)
    ) return std_logic_vector is
    variable crc_var  : std_logic_vector(16-1 downto 0) := crc;
    variable d        : std_logic_vector(8-1 downto 0) := data;
    variable i        : integer;
  begin
    log(NO_ID, "CRC Data : 0x" & to_hstring(data), C_SCOPE);
    log(NO_ID, "CRC Begin: 0x" & to_hstring(crc), C_SCOPE);
    
    crc_var := crc xor ("00000000" & d);  -- concatène 8 bits de 0 avec data
    
    for i in 0 to 8-1 loop
      log(NO_ID, "CRC Step : 0x" & to_hstring(crc_var) & " - " & integer'image(i) , C_SCOPE);
      if crc_var(0) = '1' then
        crc_var := ('0' & crc_var(16-1 downto 1)) xor x"A001";
      else
        crc_var := '0' & crc_var(16-1 downto 1);
      end if;
    end loop;
    log(NO_ID, "CRC End  : 0x" & to_hstring(crc_var), C_SCOPE);

    return crc_var;
  end function;
  
begin  -- architecture tb

  -----------------------------------------------------
  -- Design Under Test
  -----------------------------------------------------
  dut : PicoSoC_top
    generic map
    (FSYS                  => FSYS            
    ,FSYS_INT              => FSYS_INT        
    ,USER_BAUD_RATE        => USER_BAUD_RATE
    ,USER_NB_SWITCH        => USER_NB_SWITCH       
    ,USER_NB_LED0          => USER_NB_LED0        
    ,USER_NB_LED1          => USER_NB_LED1        
    ,RESET_POLARITY        => RESET_POLARITY  
    ,SUPERVISOR            => SUPERVISOR      
    ,USER_SAFETY           => USER_SAFETY          
    ,USER_FAULT_INJECTION  => USER_FAULT_INJECTION 
    ,USER_IT_POLARITY      => USER_IT_POLARITY
    ,USER_FAULT_POLARITY   => USER_FAULT_POLARITY  
    ,USER_UART_DEPTH_TX    => USER_UART_DEPTH_TX
    ,USER_UART_DEPTH_RX    => USER_UART_DEPTH_RX
    ,CPU_MODEL             => CPU_MODEL
     )  
    port map
    (clk_i            => clk_i           
    ,arst_i           => arst_b_i        
    ,switch_i         => switch_i        
    ,led0_o           => led0_o
    ,led1_o           => led1_o
    ,led_diff_o       => led_diff_o
    ,it_user_i        => it_user_i     
    ,inject_error_i   => inject_error_i
    ,uart_tx_o        => uart_tx_o
    ,uart_rx_i        => uart_rx_i
    ,uart_cts_b_i     => '0'
    ,uart_rts_b_o     => open
    ,spi_sclk_io      => open
    ,spi_cs_b_io      => open
    ,spi_io_io        => open
    ,debug_mux_i      => "000"
    ,debug_o          => open 
    ,debug_uart_tx_o  => open
    );

  
  -----------------------------------------------------------------------------
  -- Clock Generator
  -----------------------------------------------------------------------------
  clock_generator(clk_i, cke, C_CLK_PERIOD, "TB Clock", 50);

  ------------------------------------------------
  -- PROCESS: p_main
  ------------------------------------------------
  p_main: process
    constant C_SCOPE     : string  := C_TB_SCOPE_DEFAULT;

    variable modbus_crc : std_logic_vector(16-1 downto 0);

    procedure run(
      constant n            : in positive           -- nb cycle
       ) is
    begin
      wait for n*C_CLK_PERIOD;
    end run;
    
    procedure modbus_tx_begin(
      constant msg          : in string
      ) is
    begin
      log(ID_LOG_HDR, msg, C_SCOPE);

      modbus_crc         := (others => '1');
      debug_crc          <= modbus_crc;
    end;
    
    procedure modbus_tx(
      constant data_value   : in std_logic_vector;
      constant msg          : in string
      ) is
    begin
      uart_transmit(data_value,msg,uart_rx_i,C_UART_BFM_CONFIG);
      modbus_crc := crc16_next(modbus_crc,data_value);
      debug_crc  <= modbus_crc;
    end;

    procedure modbus_tx_end(
      constant msg          : in string
      ) is
    begin
      uart_transmit(modbus_crc( 7 downto 0),msg,uart_rx_i,C_UART_BFM_CONFIG);
      uart_transmit(modbus_crc(15 downto 8),msg,uart_rx_i,C_UART_BFM_CONFIG);
    end;

    procedure modbus_rx_begin(
      constant msg          : in string
      ) is
    begin
      log(ID_LOG_HDR, msg, C_SCOPE);

      modbus_crc         := (others => '1');
      debug_crc          <= modbus_crc;
    end;
    
    procedure modbus_rx(
      constant data_exp     : in std_logic_vector;
      constant msg          : in string
      ) is
    begin
      uart_expect(data_exp,msg,uart_tx_o,uart_terminate_loop,1,1 ms,ERROR, C_UART_BFM_CONFIG);
      modbus_crc := crc16_next(modbus_crc,data_exp);
      debug_crc  <= modbus_crc;
    end;

    procedure modbus_rx_end(
      constant msg          : in string
      ) is
    begin
      uart_expect(modbus_crc( 7 downto 0),msg,uart_tx_o,uart_terminate_loop,1,1 ms,ERROR, C_UART_BFM_CONFIG);
      uart_expect(modbus_crc(15 downto 8),msg,uart_tx_o,uart_terminate_loop,1,1 ms,ERROR, C_UART_BFM_CONFIG);
    end;

    
    procedure modbus_write(
      constant addr : in std_logic_vector;
      constant data : in std_logic_vector;
      constant msg  : in string          ;
      constant id   : in std_logic_vector:=C_MODBUS_SLAVE_ID
      ) is
      begin
        modbus_tx_begin(msg);    
        modbus_tx      (id               ,"MODBUS TX Slave ID"             );
        modbus_tx      (C_MODBUS_WRITE,   "MODBUS TX Write"                );
        modbus_tx      (x"00",            "MODBUS TX Addr MSB (Ignored)"   );
        modbus_tx      (addr,             "MODBUS TX Addr LSB"             );
        modbus_tx      (x"00",            "MODBUS TX Data MSB (Ignored)"   );
        modbus_tx      (data,             "MODBUS TX Data LSB"             );
        modbus_tx_end  (                  "MODBUS TX CRC"                  );    

        if (id = C_MODBUS_SLAVE_ID)
        then
          modbus_rx_begin(msg);    
          modbus_rx      (id               ,"MODBUS TX Slave ID"             );
          modbus_rx      (C_MODBUS_WRITE,   "MODBUS TX Write"                );
          modbus_rx      (x"00",            "MODBUS TX Addr MSB (Ignored)"   );
          modbus_rx      (addr,             "MODBUS TX Addr LSB"             );
          modbus_rx      (x"00",            "MODBUS TX Data MSB (Ignored)"   );
          modbus_rx      (data,             "MODBUS TX Data LSB"             );
          modbus_rx_end  (                  "MODBUS TX CRC"                  );
        else
          wait for 200 us;
        end if;
      end;

    type t_data_array is array (natural range <>) of std_logic_vector(7 downto 0);
      
    procedure modbus_read(
      constant addr       : in std_logic_vector;
      constant data_array : in t_data_array;
      constant msg        : in string
      ) is

      variable len : natural := data_array'length;
    begin
      modbus_tx_begin(msg);    
      modbus_tx      (C_MODBUS_SLAVE_ID, "MODBUS TX Slave ID");
      modbus_tx      (C_MODBUS_READ,     "MODBUS TX Read");
      modbus_tx      (x"00",             "MODBUS TX Addr MSB (Ignored)");
      modbus_tx      (addr,              "MODBUS TX Addr LSB");
      modbus_tx      (x"00",             "MODBUS TX Len MSB (Ignored)");
      modbus_tx      (std_logic_vector(to_unsigned(len, 8)), "MODBUS TX Len LSB");
      modbus_tx_end  ("MODBUS TX CRC");

      modbus_rx_begin(msg);    
      modbus_rx      (C_MODBUS_SLAVE_ID, "MODBUS RX Slave ID");
      modbus_rx      (C_MODBUS_READ,     "MODBUS RX Read");
      modbus_rx      (std_logic_vector(to_unsigned(len * 2, 8)), "MODBUS RX Byte Count");

      for i in 0 to len - 1 loop
        modbus_rx(x"00", "MODBUS RX Data MSB (Ignored)");
        modbus_rx(data_array(i), "MODBUS RX Data LSB");
      end loop;

      modbus_rx_end("MODBUS RX CRC");
    end procedure;      

    procedure set_inputs_passive(
      dummy   : t_void) is
    begin

      switch_i        <= (others => '0');
      it_user_i       <= '0';
      inject_error_i  <= (others => '0');

      log(ID_SEQUENCER_SUB, "All inputs set passive", C_SCOPE);
    end;

  begin

    -- Print the configuration to the log
    report_global_ctrl (VOID);
    report_msg_id_panel(VOID);

    enable_log_msg     (ALL_MESSAGES);
    --disable_log_msg(ALL_MESSAGES);
    --enable_log_msg(ID_LOG_HDR);

    log(ID_LOG_HDR, "Start Simulation of TB for IRQC", C_SCOPE);
    ------------------------------------------------------------

    set_inputs_passive (VOID);

    cke <= true; -- to start clock generator

    gen_pulse(arst_b_i, '0', 10 * C_CLK_PERIOD, "Pulsed reset-signal - active for 10T");

    log(ID_LOG_HDR, "wait to finish init", C_SCOPE);
    wait for C_RESET_LATENCY;

    --==================================================================================================
    -- Test case
    --------------------------------------------------------------------------------------

    if TEST_CASE_BASIC
    then
          
      -- Write LED0 and check if led switch have the expected value
      wait for 35 us;
      modbus_write(C_LED0_DATA  ,x"21",        "Write LED0 Data <= 0x21");
      await_value (led_switch, x"21", 0 ns, C_CLK_PERIOD, ERROR, "LED0 <= 0x21", C_SCOPE);

      -- Read LED0 and check if it's the expected value
      wait for 35 us;
      modbus_read (C_LED0_DATA  ,(0 => x"21"), "Read  LED0 Data");

      -- Change Switch and check if it's the expected value
      wait for 35 us;
      switch_i <= x"5A";
      modbus_read (C_SWITCH_DATA,(0 => x"5A"), "Read  SWITCH Data");

      -- Change Switch and check if it's the expected value
      wait for 35 us;
      switch_i <= x"3C";
      modbus_read (C_SWITCH_DATA,(0 => x"3C"), "Read  SWITCH Data");

      -- Change Switch and check if it's the expected value
      wait for 35 us;
      switch_i <= x"1E";
      modbus_read (C_SWITCH_DATA,(0 => x"1E"), "Read  SWITCH Data");

      -- Write LED0 with another ID and check that the LED0 don't change
      wait for 35 us;
      modbus_write(C_LED0_DATA  ,x"23",        "Write LED0 Data <= 0x23, with another ID"
                   ,id => not C_MODBUS_SLAVE_ID
                   );
      await_value (led_switch, x"21", 0 ns, C_CLK_PERIOD, ERROR, "LED0 <= 0x21", C_SCOPE);
      
      wait for 35 us;
      modbus_read (C_LED0_DATA  ,(0 => x"21",
                                1 => x"FF"), "Read  LED0 Data & OE");
      await_value (led_switch, x"21", 0 ns, C_CLK_PERIOD, ERROR, "LED0 <= 0x21", C_SCOPE);
      
      -- Write LED0 with broadcast Address and check that the LED0 change
      wait for 35 us;
      modbus_write(C_LED0_DATA  ,x"15",        "Write LED0 Data <= 0x15, with broadcast address"
                   ,id => x"00"
                   );
      await_value (led_switch, x"15", 0 ns, C_CLK_PERIOD, ERROR, "LED0 <= 0x15", C_SCOPE);

      wait for 35 us;
      modbus_read (C_LED0_DATA  ,(0 => x"15"), "Read  LED0 Data");
    end if;
      
    -- Check ERROR
    -- When ERROR, the supervisor reset the user soc then LED0 = 0x00
    if TEST_CASE_FAULT
    then

      if (SUPERVISOR and USER_SAFETY="lock-step")
      then
        log(ID_LOG_HDR, "Inject error (lock-step)", C_SCOPE);

        wait for C_RESET_LATENCY;
        wait for 35 us;
        modbus_write(C_LED0_DATA  ,x"DE",        "Write LED0 Data <= 0xDE"
                     );
        await_value (led_switch, x"DE", 0 ns, C_CLK_PERIOD, ERROR, "LED0 <= 0xDE", C_SCOPE);

        log(NO_ID, "Inject error in CPU0", C_SCOPE);
        inject_error_i(0) <= '1';
        wait for C_ERROR_DURATION;
        inject_error_i(0) <= '0';
        wait for C_ERROR_LATENCY;
        await_value (led_switch, x"00", 0 ns, C_CLK_PERIOD, ERROR, "LED0 <= 0x00 after reset ", C_SCOPE);

        wait for C_RESET_LATENCY;
        wait for 35 us;
        modbus_write(C_LED0_DATA  ,x"AD",        "Write LED0 Data <= 0xAD"
                     );
        await_value (led_switch, x"AD", 0 ns, C_CLK_PERIOD, ERROR, "LED0 <= 0xAD", C_SCOPE);

        log(NO_ID, "Inject error in CPU1", C_SCOPE);
        inject_error_i(1) <= '1';
        wait for C_ERROR_DURATION;
        inject_error_i(1) <= '0';
        wait for C_ERROR_LATENCY;
        await_value (led_switch, x"00", 0 ns, C_CLK_PERIOD, ERROR, "LED0 <= 0x00 after reset ", C_SCOPE);
        
        wait for C_RESET_LATENCY;
      end if;

      if (SUPERVISOR and USER_SAFETY="tmr")
      then
        log(ID_LOG_HDR, "Inject error (TMR)", C_SCOPE);

        wait for C_RESET_LATENCY;

        wait for 35 us;
        modbus_write(C_LED0_DATA  ,x"CA",        "Write LED0 Data <= 0xCA");
        await_value (led_switch, x"CA", 0 ns, C_CLK_PERIOD, ERROR, "LED0 <= 0xCA", C_SCOPE);

        log(NO_ID, "Inject error in CPU0", C_SCOPE);
        inject_error_i(0) <= '1';
        wait for C_ERROR_DURATION;
        inject_error_i(0) <= '0';
        wait for C_ERROR_LATENCY;
        await_value (led_switch, x"CA", 0 ns, C_CLK_PERIOD, ERROR, "LED0 <= 0xCA (CPU0)", C_SCOPE);

        wait for 35 us;
        modbus_write(C_LED0_DATA  ,x"FE",        "Write LED0 Data <= 0xFE");
        await_value (led_switch, x"FE", 0 ns, C_CLK_PERIOD, ERROR, "LED0 <= 0xFE", C_SCOPE);

        log(NO_ID, "Inject error in CPU1", C_SCOPE);
        inject_error_i(1) <= '1';
        wait for C_ERROR_DURATION;
        inject_error_i(1) <= '0';
        wait for C_ERROR_LATENCY;
        await_value (led_switch, x"00", 0 ns, C_CLK_PERIOD, ERROR, "LED0 <= 0x00 after reset (CPU1)", C_SCOPE);
        
        wait for C_RESET_LATENCY;

        wait for 35 us;
        modbus_write(C_LED0_DATA  ,x"ED",        "Write LED0 Data <= 0xED");
        await_value (led_switch, x"ED", 0 ns, C_CLK_PERIOD, ERROR, "LED0 <= 0xED", C_SCOPE);

        log(NO_ID, "Inject error in CPU2", C_SCOPE);
        inject_error_i(2) <= '1';
        wait for C_ERROR_DURATION;
        inject_error_i(2) <= '0';
        wait for C_ERROR_LATENCY;
        await_value (led_switch, x"ED", 0 ns, C_CLK_PERIOD, ERROR, "LED0 <= 0x00 (CPU2)", C_SCOPE);

        log(NO_ID, "Inject error in CPU0", C_SCOPE);
        inject_error_i(0) <= '1';
        wait for C_ERROR_DURATION;
        inject_error_i(0) <= '0';
        wait for C_ERROR_LATENCY;
        await_value (led_switch, x"00", 0 ns, C_CLK_PERIOD, ERROR, "LED0 <= 0x00 after reset (CPU0)", C_SCOPE);

        wait for C_RESET_LATENCY;

        wait for 35 us;
        modbus_write(C_LED0_DATA  ,x"21",        "Write LED0 Data <= 0x21");
        await_value (led_switch, x"21", 0 ns, C_CLK_PERIOD, ERROR, "LED0 <= 0x21", C_SCOPE);

        log(NO_ID, "Inject error in CPU1", C_SCOPE);
        inject_error_i(1) <= '1';
        wait for C_ERROR_DURATION;
        inject_error_i(1) <= '0';
        wait for C_ERROR_LATENCY;
        await_value (led_switch, x"21", 0 ns, C_CLK_PERIOD, ERROR, "LED0 <= 0x21 (CPU1)", C_SCOPE);

        wait for 35 us;
        modbus_write(C_LED0_DATA  ,x"04",        "Write LED0 Data <= 0x04");
        await_value (led_switch, x"04", 0 ns, C_CLK_PERIOD, ERROR, "LED0 <= 0x04", C_SCOPE);

        log(NO_ID, "Inject error in CPU2", C_SCOPE);
        inject_error_i(2) <= '1';
        wait for C_ERROR_DURATION;
        inject_error_i(2) <= '0';
        wait for C_ERROR_LATENCY;
        await_value (led_switch, x"00", 0 ns, C_CLK_PERIOD, ERROR, "LED0 <= 0x00 after reset (CPU2)", C_SCOPE);
        
        wait for C_RESET_LATENCY;

        end if;
    end if;

    if TEST_CASE_SEQUENCE
    then
      wait for 35 us;
      -- Perform change switch one by one, read switch and write in LED0
      for i in 0 to 7 loop
        switch_i    <= x"00";
        switch_i(i) <= '1';
        wait for 35 us;
        modbus_read (C_SWITCH_DATA,(0 => switch_i), "Read  SWITCH Data - 0x" & to_hstring(switch_i));
        wait for 35 us;
        modbus_write(C_LED0_DATA  ,switch_i       , "Write LED0 Data - 0x" & to_hstring(switch_i));
        await_value (led_switch, switch_i, 0 ns, C_CLK_PERIOD, ERROR, "LED0 <= 0x" & to_hstring(switch_i), C_SCOPE);

      end loop;  -- i
    end if;
    
    -- Checks modbus error
    -- 1) bad slave id
    -- 2) bad function code
    -- 3) write addr msb
    -- 4) write data msb
    -- 5) read addr msb
    -- 6) read data msb
    -- 7) bad crc
        
    --==================================================================================================
    -- Ending the simulation
    --------------------------------------------------------------------------------------
    wait for TB_WATCHDOG*C_CLK_PERIOD; -- to allow some time for completion
    report_alert_counters(FINAL);      -- Report final counters and print conclusion for simulation (Success/Fail)
    log(ID_LOG_HDR, "SIMULATION COMPLETED", C_SCOPE);

    -- Finish the simulation
    std.env.stop;
    wait;  -- to stop completely

  end process p_main;

  
end architecture tb;
