deuskane/asylum-soc-picosoc/(commit log)

2025-01-14 identity.c : add define to invert the led
2025-01-15 top : swap led2 and led1 in led vector
    [OB8_GPIO_top.vhd]
2025-01-22 add uart pads
2025-01-22 Add uart
2025-01-22 tb : add uart output
2025-01-22 reorder switch
2025-01-22 Core : add compil with uart
2025-01-31 tb : increase inject error delay
    [tb_OB8_GPIO.vhd]
2025-04-02 remove ID parameters for gpio and uart
2025-04-05 Change address to be compliant with one hot
    [identity.psm]
2025-04-14 Rename all led vector in top
2025-04-30 UART Configuration
2025-05-06 Use baud rate selection of uart
2025-05-14 fix size of parameters DATA_OE_INIT
    [OB8_GPIO_supervisor.vhd, OB8_GPIO_user.vhd]
2025-06-13 Add SPI
2025-06-13 Connection of spi
2025-06-25 Reduce BAUD_RATE in board
2025-06-28 Rename user
    [user_identity.psm]
2025-07-29 use new regmap of uart
2025-07-30 soft: add getchar to read uart
2025-07-30 user.c : add IT to read uart
2025-08-01 Move directory
    [user_identity.psm]
2025-08-02 UART : Add CTS/RTS ports
2025-08-02 Add UART CTS/RTS in pads
2025-08-03 esw : fix bit of uart loopback
    [uart.h]
2025-08-10 Top : introduce reset top works with clk not divided
    [PicoSoC_top.vhd]
2025-08-10 Increase duration of error injection
    [tb_PicoSoC.vhd]
2025-08-16 Inject error on msb
    [PicoSoC_user.vhd]
2025-08-31 Makefile : Remove fusesoc generated cache
2025-10-19 modbus : replace array by getchar
    [user_modbus_rtu.c]
2025-10-23 modprobe write working (missing crc)
    [user_modbus_rtu.c]
2025-10-31 tb modbus : read switch via modbus
2025-11-02 Add timer
2025-11-02 modprobe : fix wait function with clear it
    [user_modbus_rtu.c]
2025-11-04 modbus : use fonction to check id (compilation workaround)
    [user_modbus_rtu.c]
2025-11-05 add uart into debug bus
2025-11-05 modbus_server : read switch
2025-11-10 Add debug bus from uart
2025-11-10 Add debug bus from uart and set to 4 the FIFO depth
2025-12-03 Update address map
    [user_identity.psm]
2025-12-11 modus_server : fix import value in base 16
    [modbus_server.py]
2026-05-17 interruption : rename function without pbcc prefix
2026-05-20 Makefile : add filter option
2026-05-20 Makefile : add help for filter option
2026-05-20 Add cpu api for interrupt
2026-05-20 esw: update with new interrupt hal
2026-05-20 cpu_safety : inject error directly on the opcode, depends of the ISA
    [cpu_safety.vhd]
2026-05-22 cpu_safety : fix typo
    [cpu_safety.vhd]
2026-05-22 modbus_rtl tb : add wait for reset wait
    [tb_PicoSoC_modbus_rtu.vhd]
2026-06-02 esw : add mailbox and update isr
    [user_identity.psm]
2026-06-02 sim : display the switch activity
2026-06-06 Update LED parameters, add module NAME
2026-06-26 Fix addresses
    [user_identity.psm]
2026-08-01 Update software and testbench to match with gpio_irq
    [user_identity.psm]
2026-08-22 Update SPI Controller
2026-08-22 unify tb_PicoSoC and tb_PicoSoC_run, PicoSoC_user have now 8b spi
2026-08-24 select size of spi io
2026-08-24 Add io buffer in PicoSoC_top for SPI
2026-08-26 TB : use io bidir for spi and add s25fl model
